kharper55/LiFi-Serial/Photos and Captures/Test Fixture/Front.jpg

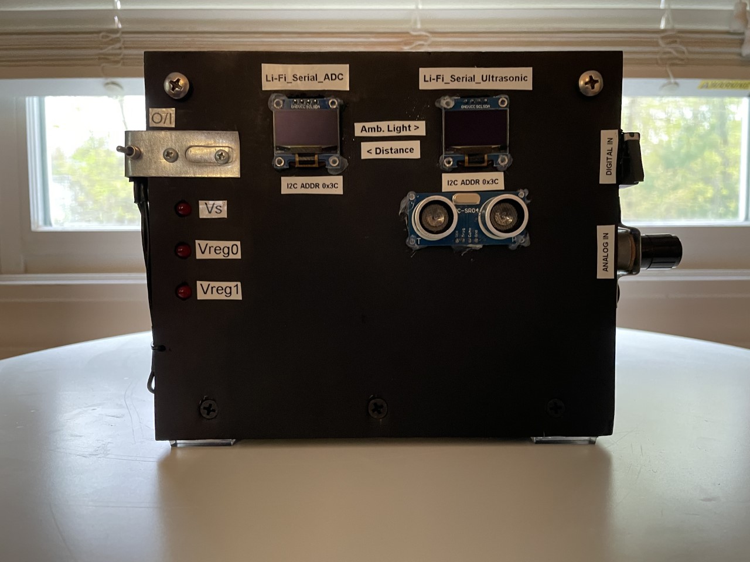
Photos and Captures/Test Fixture/Front.jpg
