kharper55/LiFi-Serial/Photos and Captures/Test Fixture/rear.jpg

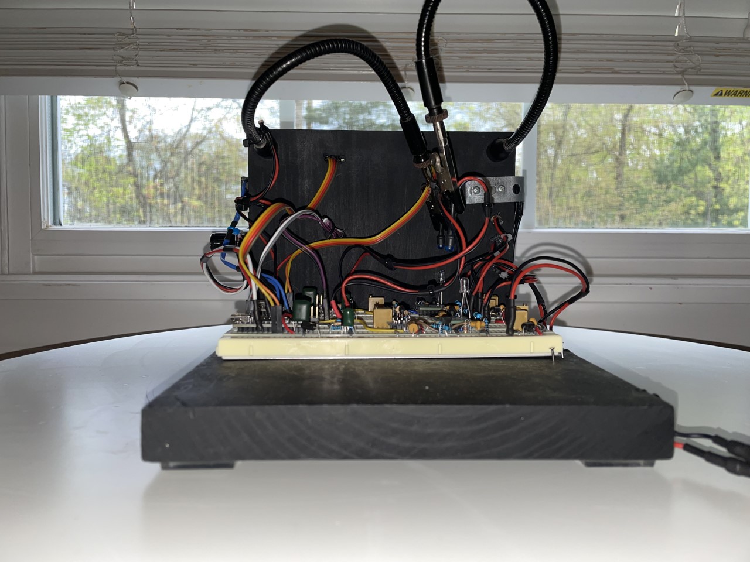
Photos and Captures/Test Fixture/rear.jpg
