kharper55/LiFi-Serial/Flowcharts/LiFi Serial_ ADC - Algorithm flowchart example (2).png

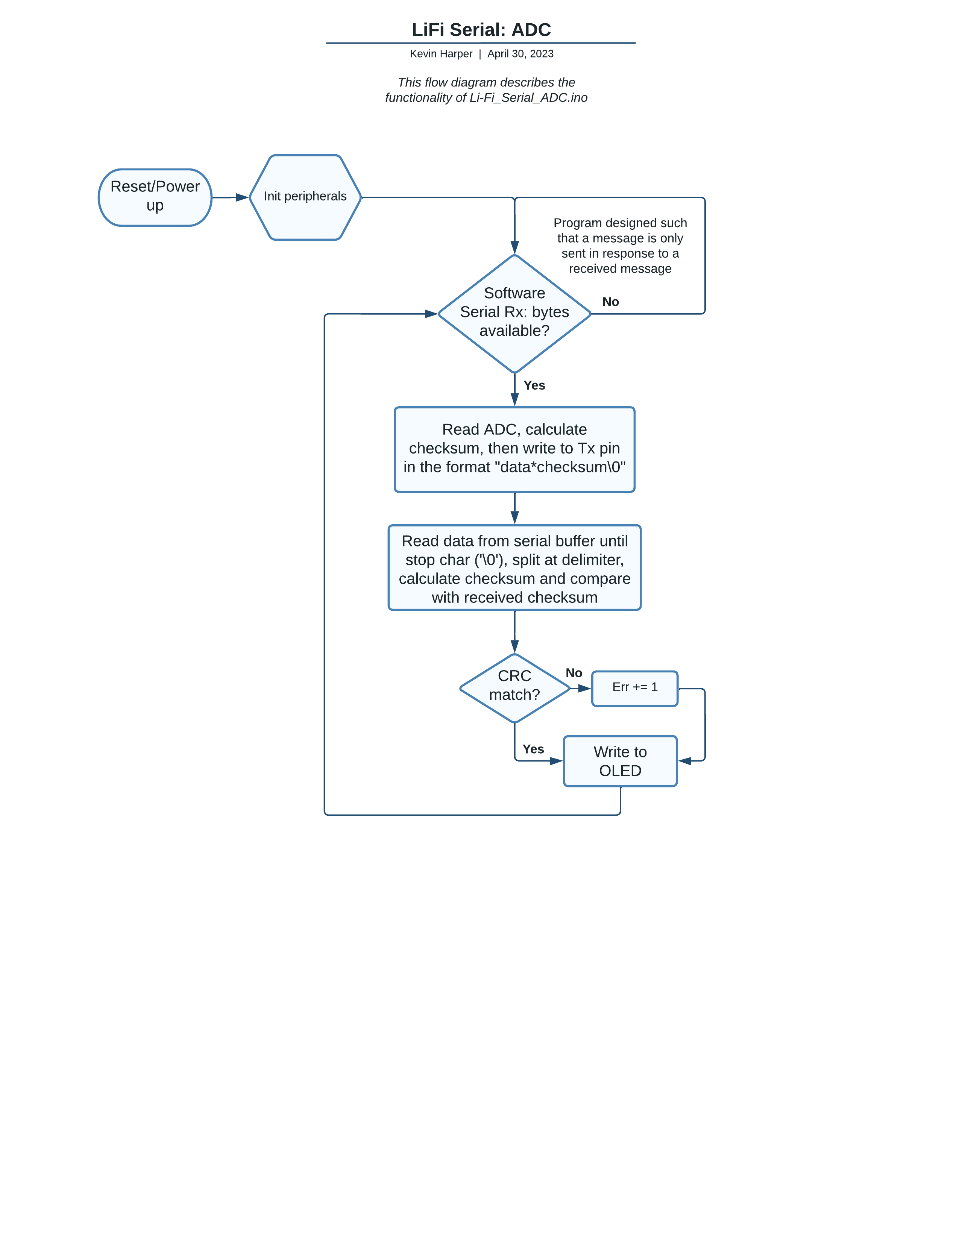
Flowcharts/LiFi Serial_ ADC - Algorithm flowchart example (2).png
