kharper55/LiFi-Serial/Photos and Captures/Scope Captures/bmps/ADCchecksum.bmp

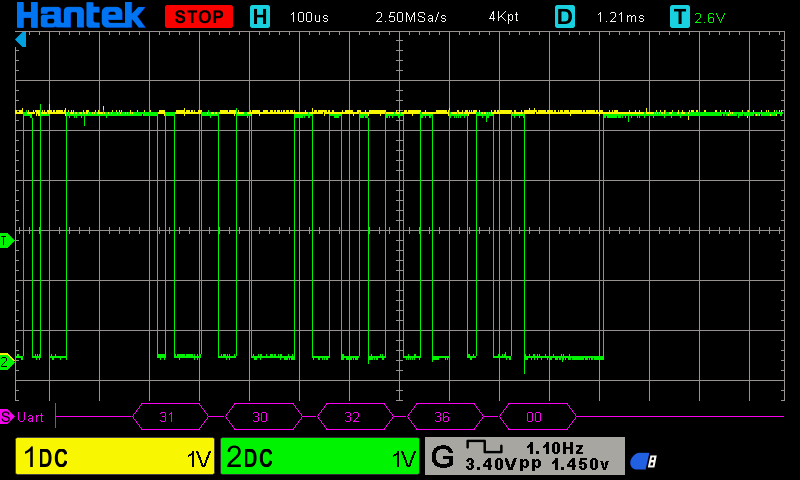
Photos and Captures/Scope Captures/bmps/ADCchecksum.bmp
