kharper55/LiFi-Serial/Photos and Captures/Scope Captures/bmps/ADCmsg.bmp

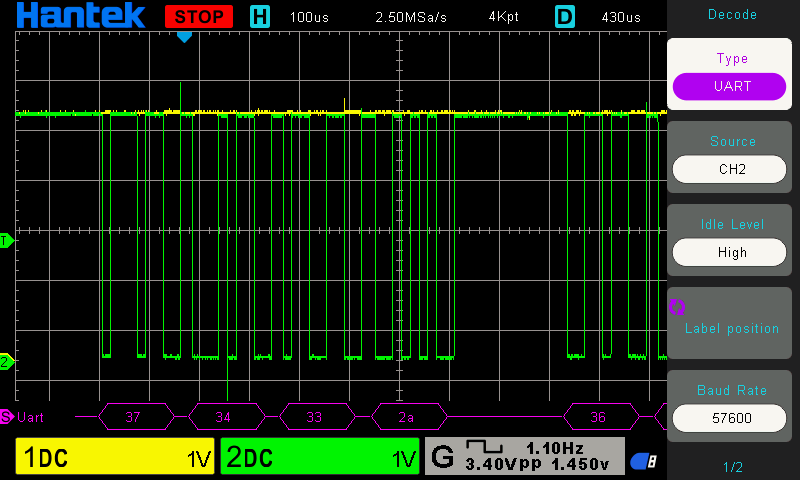
Photos and Captures/Scope Captures/bmps/ADCmsg.bmp
