kharper55/LiFi-Serial/Photos and Captures/Scope Captures/bmps/HalfDuplexProof.bmp

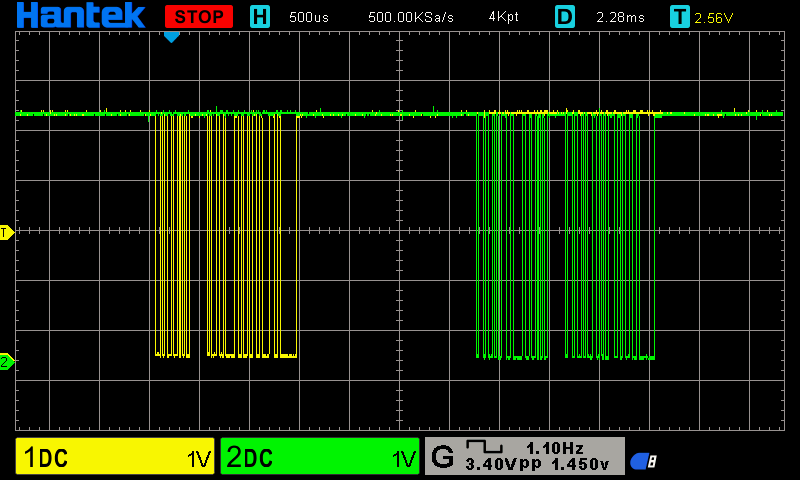
Photos and Captures/Scope Captures/bmps/HalfDuplexProof.bmp
