kharper55/LiFi-Serial/Photos and Captures/Scope Captures/bmps/HCSR04msg.bmp

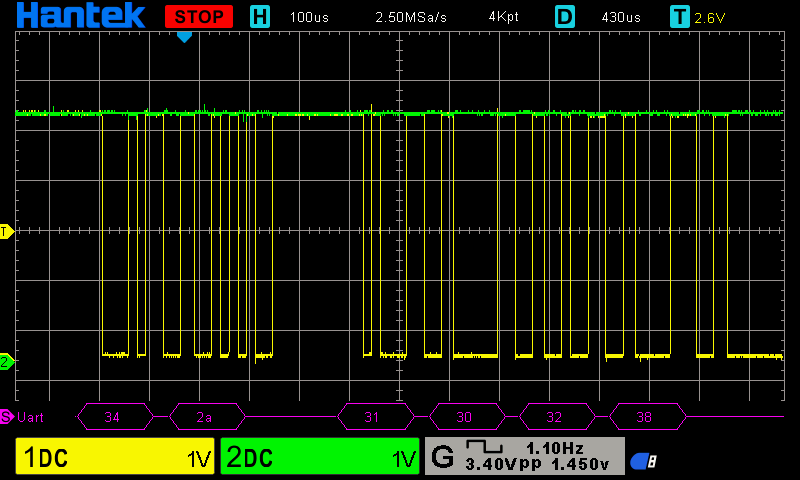
Photos and Captures/Scope Captures/bmps/HCSR04msg.bmp
