kharper55/LiFi-Serial/Photos and Captures/Scope Captures/bmps/HFpwm-OA&Comparator.bmp

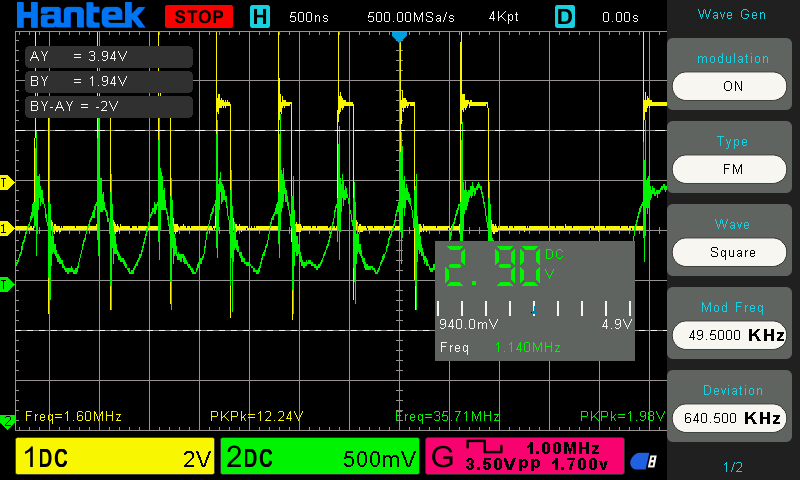
Photos and Captures/Scope Captures/bmps/HFpwm-OA&Comparator.bmp
