kharper55/LiFi-Serial/Photos and Captures/Scope Captures/bmps/opampVsComparatorOPs.bmp

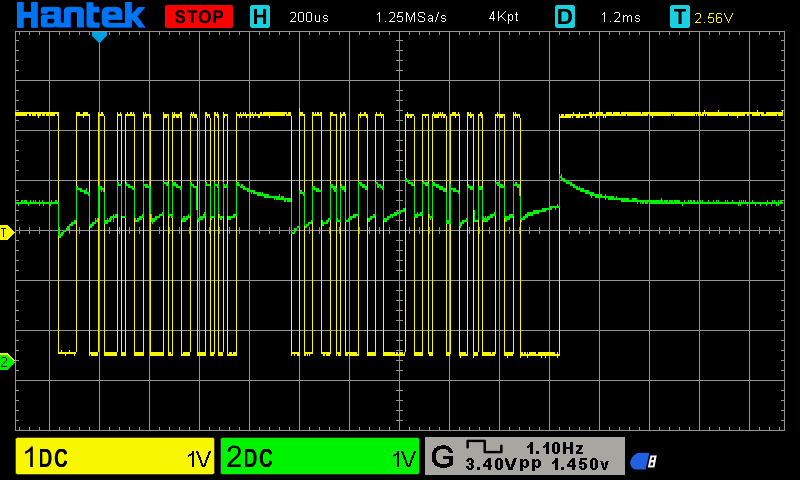
Photos and Captures/Scope Captures/bmps/opampVsComparatorOPs.bmp
