kharper55/LiFi-Serial/Photos and Captures/Scope Captures/bmps/timeDelay.bmp

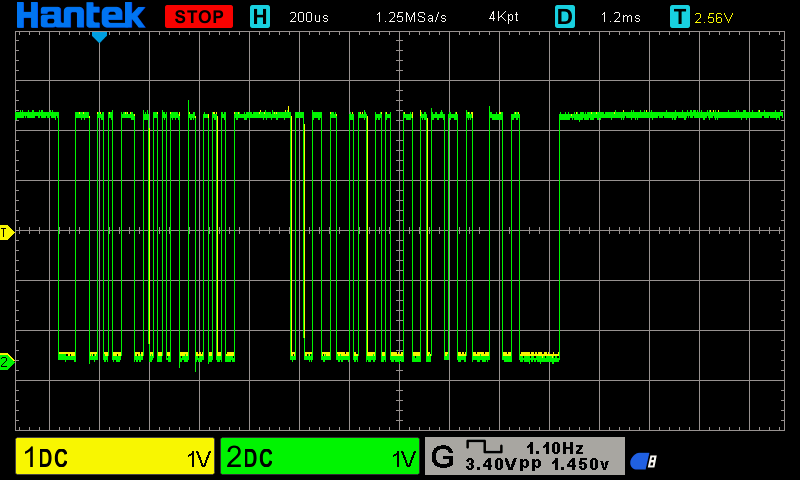
Photos and Captures/Scope Captures/bmps/timeDelay.bmp
