kharper55/LiFi-Serial/Photos and Captures/Scope Captures/bmps/TransmitterEx.bmp

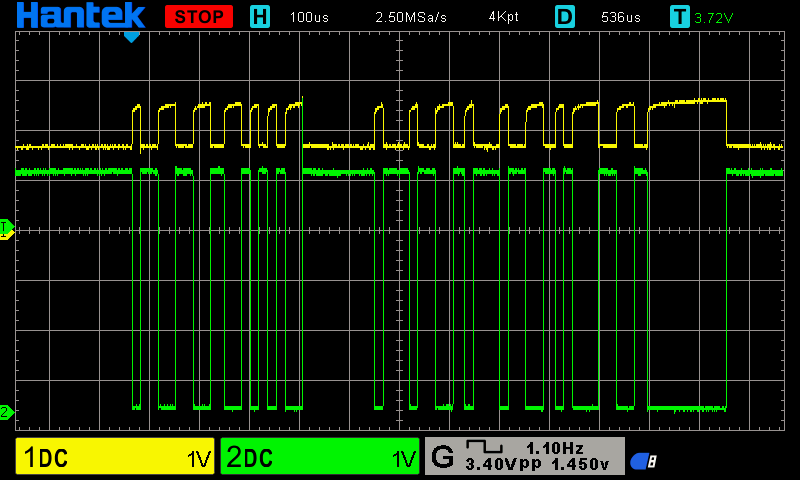
Photos and Captures/Scope Captures/bmps/TransmitterEx.bmp
