kharper55/LiFi-Serial/Photos and Captures/Scope Captures/bmps/VRailNoise.bmp

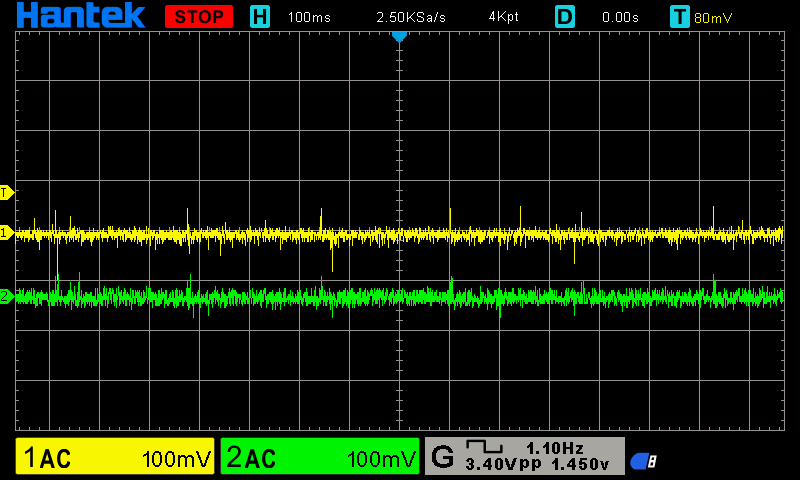
Photos and Captures/Scope Captures/bmps/VRailNoise.bmp
