kharper55/LiFi-Serial/Photos and Captures/Scope Captures/bmps/ZoomedTimeDelay.bmp

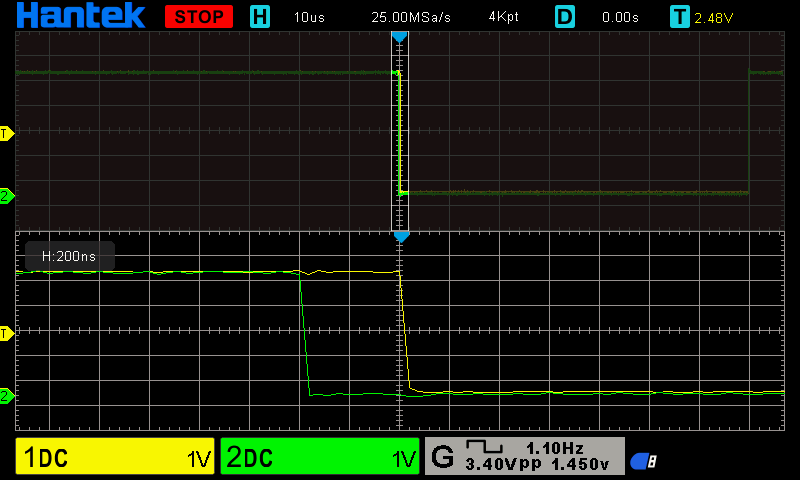
Photos and Captures/Scope Captures/bmps/ZoomedTimeDelay.bmp
