kharper55/LiFi-Serial/References/ASCII-Table-wide.svg.png

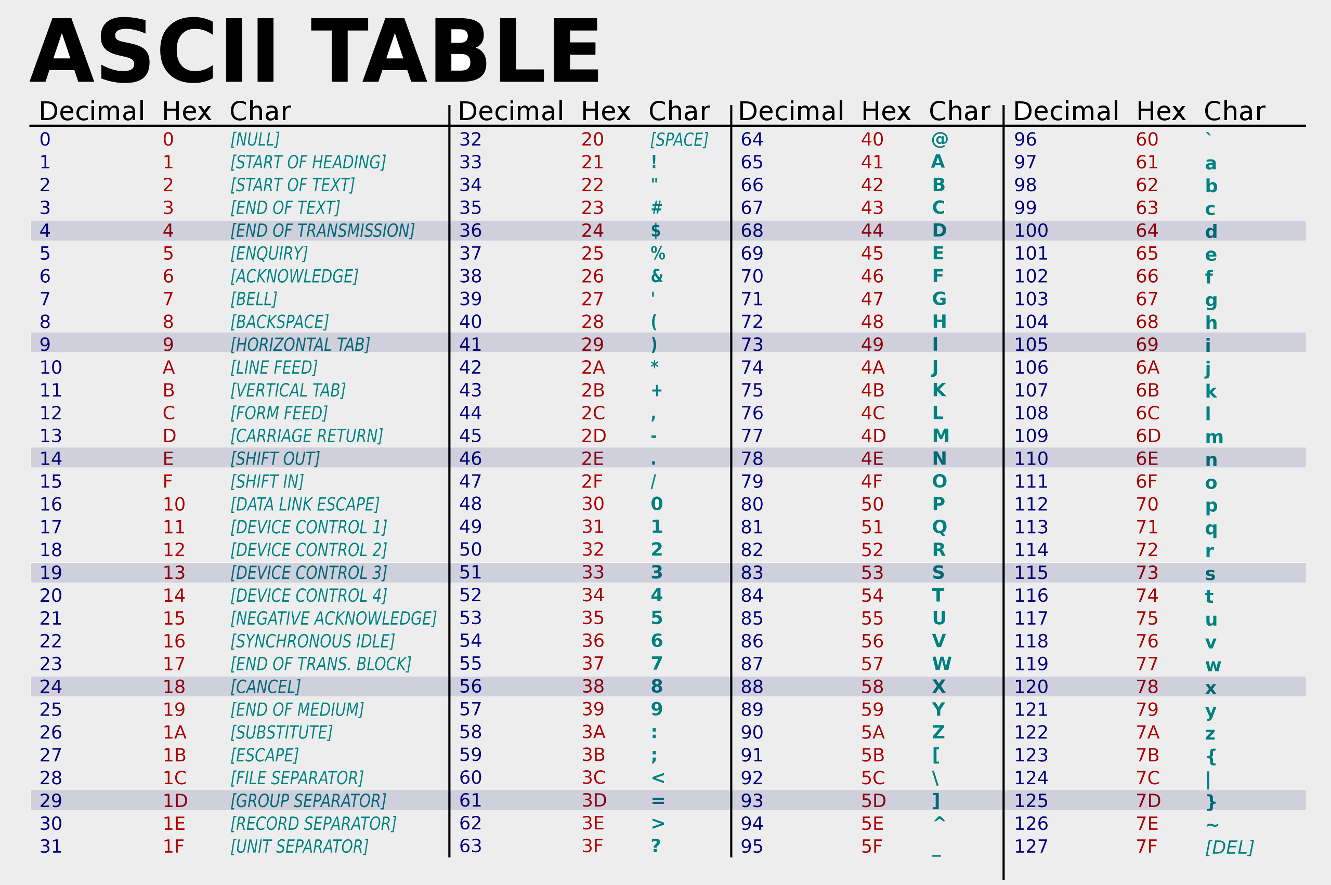
References/ASCII-Table-wide.svg.png
