kharper55/LiFi-Serial/Schematics/LiFiREVA.png

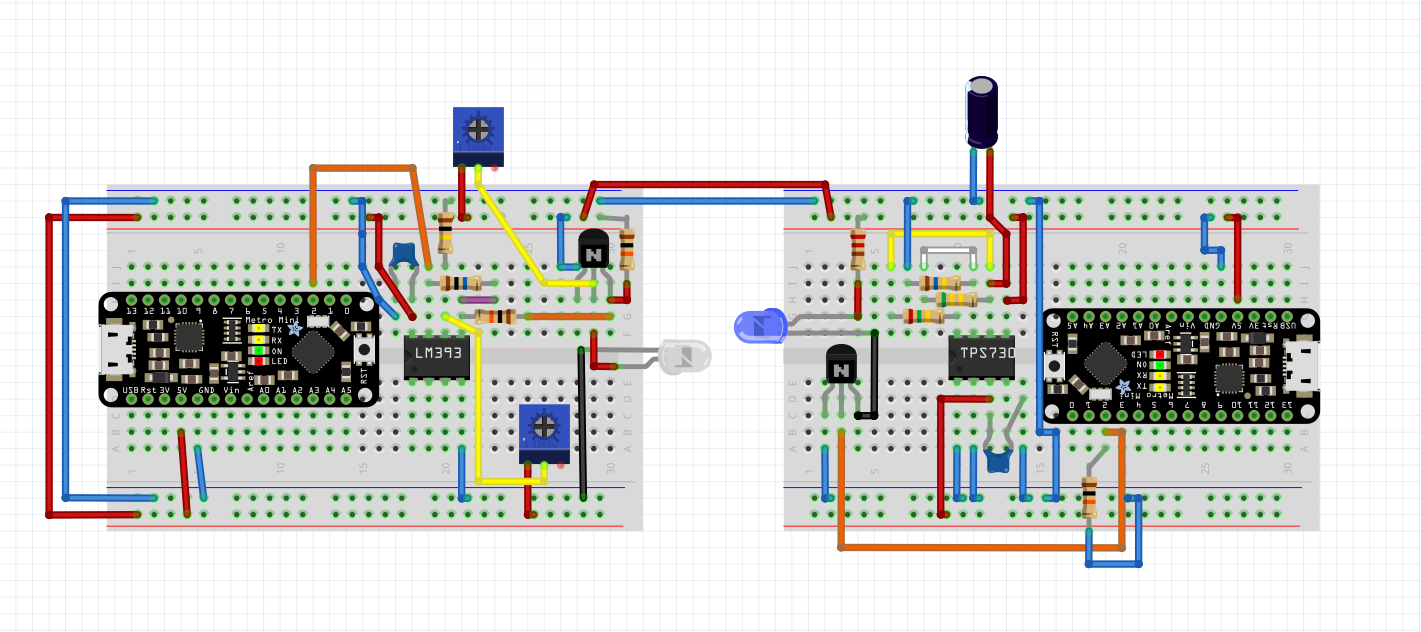
Schematics/LiFiREVA.png
