kharper55/LiFi-Serial/Schematics/powersupply.png

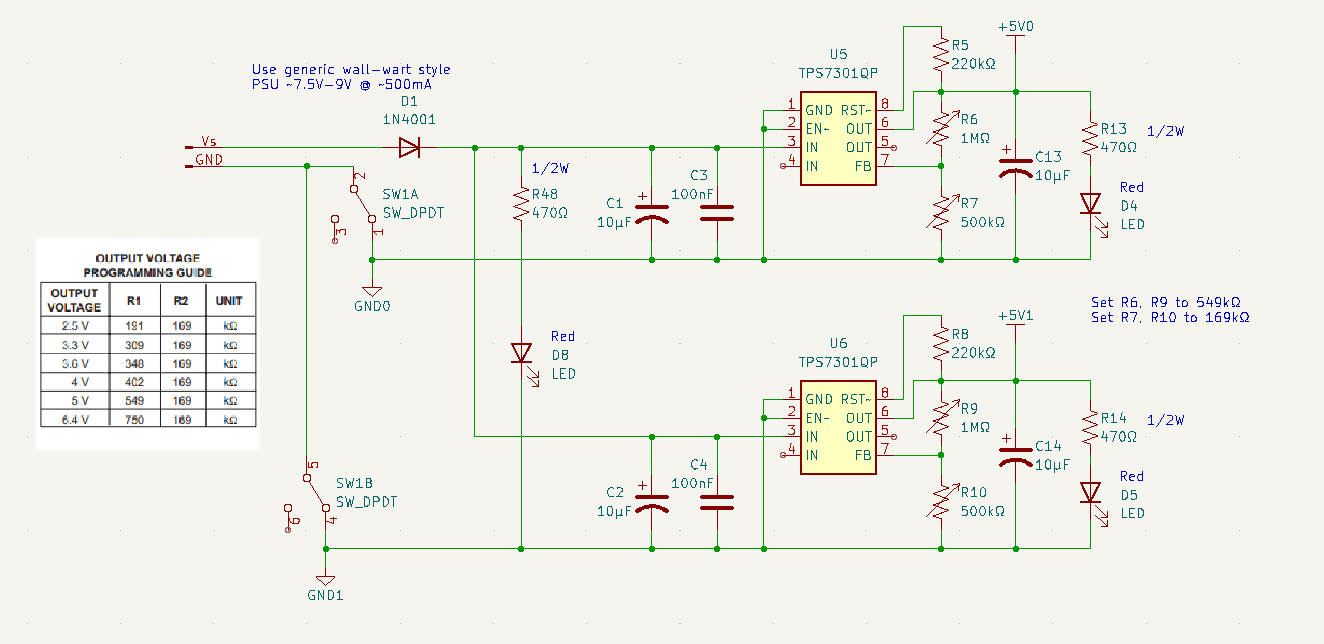
Schematics/powersupply.png
