kharper55/LiFi-Serial/Schematics/receiver.png

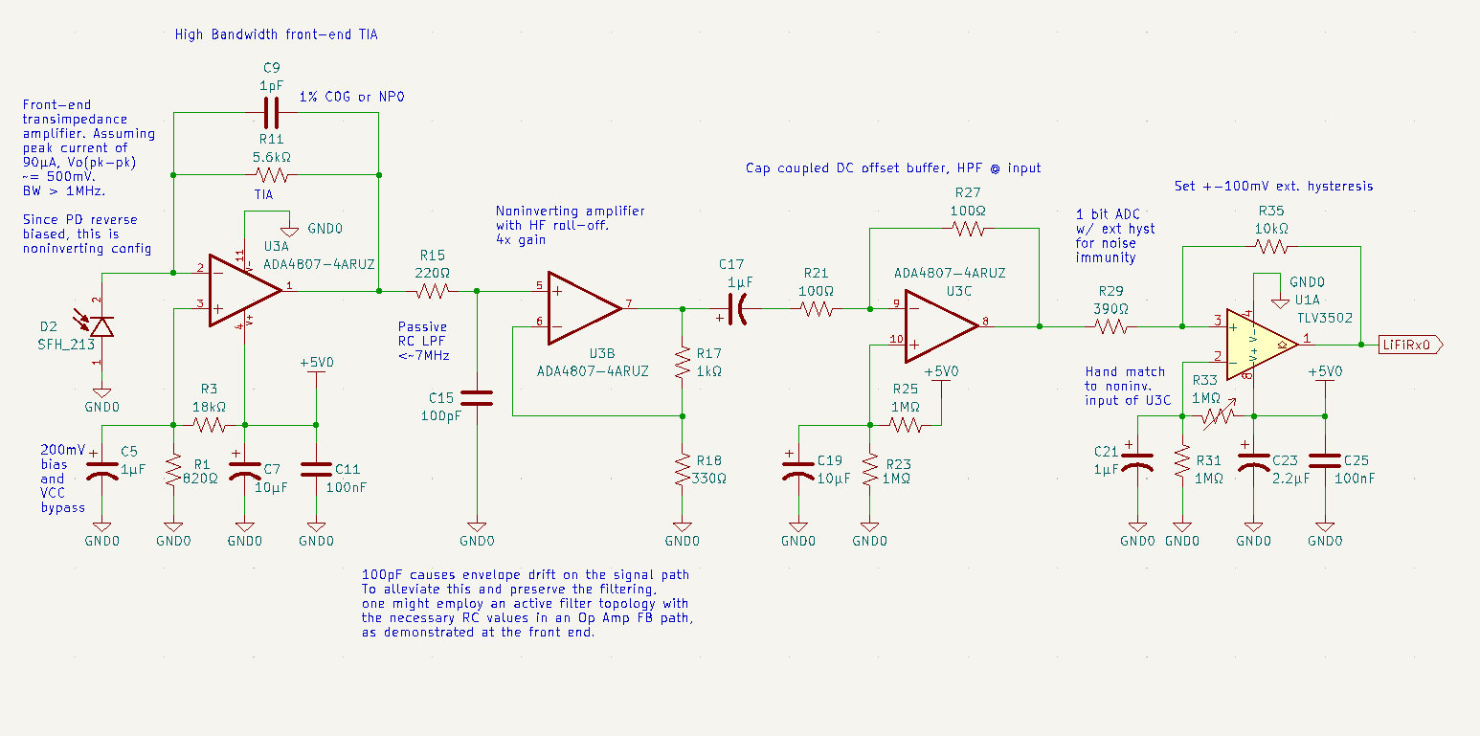
Schematics/receiver.png
