kharper55/LiFi-Serial/Schematics/transmitter.png

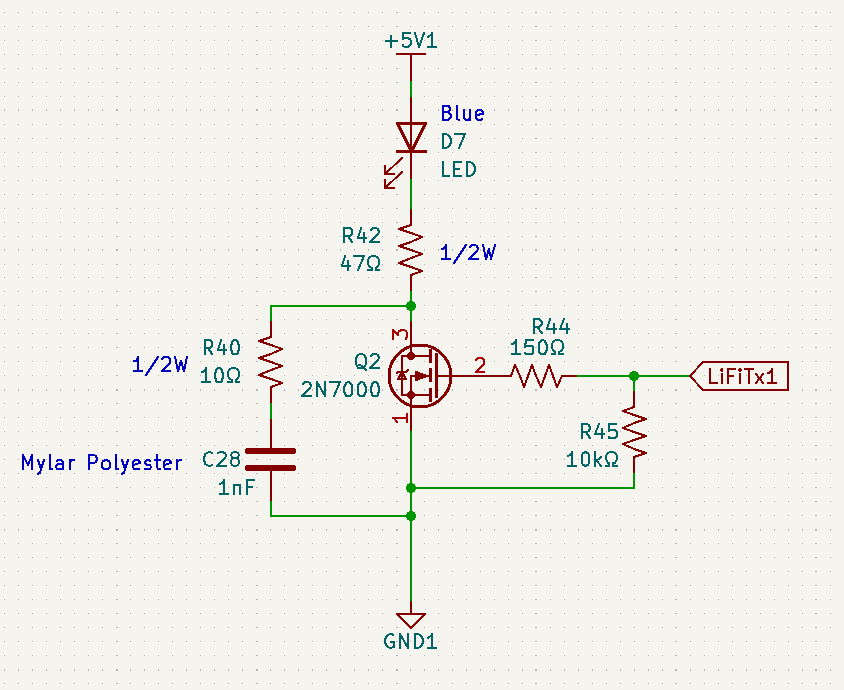
Schematics/transmitter.png
