kharper55/LiFi-Serial/Spr 2023 Li-Fi - BOM.xlsx

Item | Qty | Reference Designators | Description | Value | Manufacturer/Source | MPN | Datasheet | Unit Price
1 | 8 | C1, C2, C7, C8, C13, C14, C19, C20 | 10 µF Molded Tantalum Capacitors 10 V Axial | 10µF | Vishay Sprague | 173D106X9010VWE3 | https://www.vishay.com/docs/40019/173d.pdf | $1.55
2 | 8 | C3, C4, C11, C12, C25, C26, C29, C31 | CAP CER 0.1UF 50V Z5U RADIAL | 100nF | Kemet | C315C104M5U5TA7303 | https://connect.kemet.com:7667/gateway/IntelliData-ComponentDocumentation/1.0/download/specsheet/C315C104M5U5TA7303 | $0.32
3 | 8 | C5, C6, C17, C18, C21, C22, C30, C32 | 1 µF Molded Tantalum Capacitors 35 V Axial 8Ohm | 1µF | Kemet | T322B105K035AT | https://connect.kemet.com:7667/gateway/IntelliData-ComponentDocumentation/1.0/download/datasheet/T322B105K035AT | $4.52
4 | 2 | C9, C10 | Multilayer Ceramic Capacitors MLCC - Leaded, 1% C0G NP0 | 1pF | Murata | RCE5C1H1R0C0K1H03B | https://www.mouser.com/datasheet/2/281/RCE_C0G_50V_100V_E-1671015.pdf | $0.48 | Components grabbed are not necessarily representative of what's on the board, but rather the first match for spec and component package and availability on Digikey or Mouser. BOM cost can be greatly reduced by replacing some of the tantalum capacitors with electrolytics along with swapping for lower spec'd IC's (performance will decrease)
5 | 2 | C15, C16 | 100 pF ±5% 200V Ceramic Capacitor C0G, NP0 Radial | 100pF | Kemet | C317C101J2G5TA | https://content.kemet.com/datasheets/KEM_C1049_GOLDMAX_C0G.pdf | $0.43
6 | 2 | C23, C24 | 2.2 µF Molded Tantalum Capacitors 25 V Axial | 2.2µF | Vishay Sprague | 173D225X9025VWE3 | https://www.vishay.com/docs/40019/173d.pdf | $1.55
7 | 2 | C27, C28 | 1000 pF Film Capacitor 100V Polyester Radial | 1nF | Nichicon | QYX2A102JTP | https://www.nichicon.co.jp/english/series_items/catalog_pdf/e-qyx.pdf | $0.44
8 | 1 | D1 | Rectifiers Diode, DO-41, 50V, 1A | N/A | Diotec | 1N4001 | https://www.mouser.com/datasheet/2/849/1n4001-2577232.pdf | $0.40
9 | 2 | D2, D3 | Silicon PIN Photodiode | N/A | ams Osram | SFH213 | https://docs.rs-online.com/f594/0900766b814f568d.pdf | $0.87
10 | 3 | D4, D5, D8 | Red 630nm LED Indication - Discrete 2V Radial | N/A | Rohm | SLR-56VC3F | https://fscdn.rohm.com/en/products/databook/datasheet/opto/led/lamp_mono/slr-56-e.pdf | $0.53
11 | 2 | D6, D7 | Blue 470nm LED Indication - Discrete 3.2V Radial | N/A | Wurth Elektronik | 151051BS04000 | https://www.we-online.com/components/products/datasheet/151051BS04000.pdf | $0.26
12 | 2 | J2, J3 | HiLetgo 0.96" SSD1306 I2C IIC SPI Serial 128X64 OLED LCD Display 4 Pin Font Color White | N/A | Amazon/HILETGO | 3-01-1234-IIC-W | https://www.vishay.com/docs/37902/oled128o064dbpp3n00000.pdf | $7.29
13 | 2 | Q1, Q2 | N-Channel Enhancement FET, Logic Level | N/A | Fairchild | 2N7000 | https://rocelec.widen.net/view/pdf/orqxwkxkq1/ONSM-S-A0003544006-1.pdf?t.download=true&u=5oefqw | $0.51
14 | 2 | R1, R2 | 820 Ohms ±1% 0.25W, 1/4W Through Hole Resistor Axial Flame Retardant Coating, Safety Metal Film | 820Ω | Stackpole Electronics Inc | RNMF14FTC820R | https://www.seielect.com/Catalog/SEI-RNF_RNMF.pdf | $0.10
15 | 2 | R3, R4 | 18 kOhms ±1% 0.25W, 1/4W Through Hole Resistor Axial Flame Retardant Coating, Safety Metal Film | 18kΩ | Stackpole Electronics Inc | RNMF14FTC18K0 | https://www.seielect.com/Catalog/SEI-RNF_RNMF.pdf | $0.10
16 | 2 | R5, R8 | 220 kOhms ±1% 0.25W, 1/4W Through Hole Resistor Axial Flame Retardant Coating, Safety Metal Film | 220kΩ | Stackpole Electronics Inc | RNMF14FTC220K | https://www.seielect.com/Catalog/SEI-RNF_RNMF.pdf | $0.10
17 | 2 | R7, R10 | 500 kOhms 0.5W, 1/2W PC Pins Through Hole Trimmer Potentiometer Cermet 25.0 Turn Top Adjustment | 500kΩ, Linear | Bourns Inc. | 3296W-1-504LF | https://www.bourns.com/docs/product-datasheets/3296.pdf | $2.43
18 | 2 | R11, R12 | 5.6 kOhms ±1% 0.25W, 1/4W Through Hole Resistor Axial Flame Retardant Coating, Safety Metal Film | 5.6kΩ | Stackpole Electronics Inc | RNMF14FTC5K60 | https://www.seielect.com/Catalog/SEI-RNF_RNMF.pdf | $0.10
19 | 2 | R13, R14, R48 | 470 Ohms ±1% 0.5W, 1/2W Through Hole Resistor Axial Metal Film | 470Ω | Yageo | MFR50SFRF52-470R | https://www.yageo.com/upload/media/product/productsearch/datasheet/lr/YAGEO%20MFR_datasheet_2021v1.pdf | $0.11
20 | 2 | R15, R16 | 220 Ohms ±1% 0.25W, 1/4W Through Hole Resistor Axial Flame Retardant Coating, Safety Metal Film | 220Ω | Stackpole Electronics Inc | RNMF14FTC220R | https://www.seielect.com/Catalog/SEI-RNF_RNMF.pdf | $0.10
21 | 2 | R17, R19 | 1 kOhms ±1% 0.25W, 1/4W Through Hole Resistor Axial Flame Retardant Coating, Safety Metal Film | 1kΩ | Stackpole Electronics Inc | RNMF14FTC1K00 | https://www.seielect.com/Catalog/SEI-RNF_RNMF.pdf | $0.10
22 | 2 | R18, R20 | 330 Ohms ±1% 0.25W, 1/4W Through Hole Resistor Axial Flame Retardant Coating, Safety Metal Film | 330Ω | Stackpole Electronics Inc | RNMF14FTC330R | https://www.seielect.com/Catalog/SEI-RNF_RNMF.pdf | $0.10
23 | 4 | R21, R22, R27, R28 | 100 Ohms ±1% 0.25W, 1/4W Through Hole Resistor Axial Flame Retardant Coating, Safety Metal Film | 100Ω | Stackpole Electronics Inc | RNF14FTD100R | https://www.seielect.com/Catalog/SEI-RNF_RNMF.pdf | $0.10
24 | 6 | R23, R24, R25, R26, R31, R32 | 1 MOhms ±1% 0.25W, 1/4W Through Hole Resistor Axial Flame Retardant Coating, Safety Metal Film | 1MΩ | Stackpole Electronics Inc | RNF14FTD1M00 | https://www.seielect.com/Catalog/SEI-RNF_RNMF.pdf | $0.10
25 | 2 | R29, R30 | 390 Ohms ±1% 0.25W, 1/4W Through Hole Resistor Axial Flame Retardant Coating, Safety Metal Film | 390Ω | Stackpole Electronics Inc | RNMF14FTC390R | https://www.seielect.com/Catalog/SEI-RNF_RNMF.pdf | $0.10
26 | 4 | R6, R9, R33, R34 | 1 MOhms 0.5W, 1/2W PC Pins Through Hole Trimmer Potentiometer Cermet 25.0 Turn Top Adjustment | 1MΩ, Linear | Bourns Inc. | 3296Y-1-105LF | https://www.bourns.com/docs/product-datasheets/3296.pdf | $2.43
27 | 6 | R35, R36, R41, R43, R45, R46 | 10 kOhms ±5% 0.25W, 1/4W Through Hole Resistor Axial Flame Retardant Coating, Safety Carbon Film | 10kΩ | Stackpole Electronics Inc | CF14JT10K0 | https://www.seielect.com/Catalog/SEI-CF_CFM.pdf | $0.10
28 | 2 | R37, R40 | 10 Ohms ±1% 0.5W, 1/2W Through Hole Resistor Axial Metal Film | 10Ω | Yageo | MFR50SFTE52-10R | https://www.yageo.com/upload/media/product/productsearch/datasheet/lr/YAGEO%20MFR_datasheet_2021v1.pdf | $0.11
29 | 2 | R38, R42 | 47 Ohms ±1% 0.5W, 1/2W Through Hole Resistor Axial Metal Film | 47Ω | Yageo | MFR50SFTE52-47R | https://www.yageo.com/upload/media/product/productsearch/datasheet/lr/YAGEO%20MFR_datasheet_2021v1.pdf | $0.11
30 | 2 | R39, R44 | 150 Ohms ±1% 0.25W, 1/4W Through Hole Resistor Axial Flame Retardant Coating, Safety Metal Film | 150Ω | Stackpole Electronics Inc | RNF14FTD150R | https://www.seielect.com/Catalog/SEI-RNF_RNMF.pdf | $0.10
31 | 1 | R47 | Light Dependent Resistor (LDR) CdS Photocell | 6-14k | Advanced Photonix | NSL-5112 | https://www.advancedphotonix.com/wp-content/uploads/2015/07/DS-NSL-5112.pdf | $1.31
32 | 1 | RV1 | PDB18 Series - 17 mm Rotary Potentiometer | 10kΩ, Linear | Bourns Inc. | PDB181-K420K-103B | https://www.bourns.com/docs/Product-Datasheets/PDB18.pdf | $1.47
33 | 1 | SW1 | Toggle Switch DPDT Panel Mount, Right Angle | DPDT | E-Switch | 100DP1T1B1M6QE | https://sten-eswitch-13110800-production.s3.amazonaws.com/system/asset/product_line/data_sheet/129/100.pdf | $4.45
34 | 1 | SW2 | Switch SPDT Chassis Mount, Levered Limit Switch | N.O. | TE Connectivity ALCOSWITCH | SAJ25YXHL0147SDTSEQ | https://www.te.com/commerce/DocumentDelivery/DDEController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 | $1.51
35 | 2 | TB0, TB1 | Nano V3.0, Nano Board ATmega328P 5V 16M Micro-Controller Board Compatible with Arduino IDE (Nano x 3 with USB Cable) | N/A | Amazon/LAVFIN | 8541582500 | https://docs.arduino.cc/static/22b08d6798567faa67448967799d321c/A000005-datasheet.pdf | $7.33
36 | 2 | U1, U2 | 4.5-ns Rail-to-Rail High-Speed Comparator | N/A | Texas Instruments | TLV3502AIDR | https://www.ti.com/lit/ds/sbos507a/sbos507a.pdf?ts=1682147923610 | $5.01
37 | 2 | U3, U4 | High Speed Operational Amplifiers 180MHz, 3.1 nV/vHz, 1mA, RRIO Quad Opamp | N/A | Analog Devices | ADA4807-4ARUZ-R7 | https://www.mouser.com/datasheet/2/609/ADA4807_1_4807_2_4807_4-3119636.pdf | $7.99
38 | 2 | U5, U6 | 500-mA, 10V, low-dropout voltage regulator with power good & enable | N/A | Texas Instruments | TPS7301QP | https://www.ti.com/lit/ds/symlink/tps73.pdf?ts=1682220527382 | $3.38
39 | 1 | U9 | Ultrasonic Sensor 40kHz | N/A | Adafruit Industries | HC-SR04 | https://cdn.sparkfun.com/datasheets/Sensors/Proximity/HCSR04.pdf | $3.95
40 | 1 | N/A | DC 9V 0.5A 500mA Power Supply Adapter, Plug 5.5mm x 2.1mm, Center Positive,UL Listed | N/A | Amazon/Security-01 | MLF-A250900500CU | https://www.amazon.com/Security-01-Supply-Adapter-Center-Positive/dp/B09JVZ71TH?hvadid=563725902662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 | $9.99
41 | 1 | N/A | SMT Breakout PCB for SOIC-8, MSOP-8 or TSSOP-8-6 Pack | N/A | Amazon/Adafruit | 100634 | https://www.amazon.com/Adafruit-Breakout-SOIC-8-MSOP-8-TSSOP-8-6/dp/B00OKCOKVE?s=industrial | $6.96
42 | 1 | N/A | Proto-Advantage PA0033 TSSOP-14 to DIP-14 SMT Adapter (0.65 mm Pitch) | N/A | Amazon/ChipQuik | PA0033-3X | https://www.amazon.com/dp/B097Q682QY?psc=1&ref=ppx_yo2ov_dt_b_product_details | $11.07
43 | 1 | N/A | 63-37 Tin Lead Rosin Core Solder Wire for Electrical Soldering (0.6mm 50g) | N/A | Amazon/Maiyum | ‎JF650 | https://www.amazon.com/MAIYUM-63-37-Solder-Electrical-Soldering/dp/B075WBDYZZ | $8.99
44 | 1 | N/A | 10cm+20cm 240pcs Breadboard Jumper Dupont Wires Cable Kit Male to Female, Male to Male, Female to Female Compatible with Arduino Projects and Raspberry Pi | N/A | Amazon/EDGELEC | ED-DP_L20_Mix_120pcs | https://www.amazon.com/EDGELEC-Breadboard-Optional-Assorted-Multicolored/dp/B07GD2BWPY?s=industrial | $6.99
45 | 1 | N/A | 14 Vaules 840 pcs 2-125mm Solderless Flexible Breadboard Connecting Line Cables Breadboard Jumper Wires kit | N/A | Amazon/BOJACK | BJ-14V-840P | https://www.amazon.com/BOJACK-Solderless-Flexible-Breadboard-Connecting/dp/B08YRGVYPV | $13.99
46 | 1 | N/A | 24 Gauge Wire - 6 Colors Tinned Copper Wires with Silicone Rubber Insulation (Black, Red, Yellow, Green, Blue, White) 30ft / 9m Each - 24 AWG (OD: 1.6 mm) Stranded Hook Up Wires from Plusivo | N/A | Amazon/Plusivo | 24GA | https://www.amazon.com/24-Gauge-Wire-Silicone-Insulation/dp/B087TJNJZS | $16.99
47 | 1 | N/A | 22-18 AWG 0.156 in. Tab Butt Splice 5 Male 5 Female, Red (10-Pack) | N/A | Home Depot/Gardner Bender | 20-161P | https://www.homedepot.com/p/Gardner-Bender-22-18-AWG-0-156-in-Tab-Butt-Splice-5-Male-5-Female-Red-10-Pack-20-161P/205846720 | $2.95
48 | 2 | N/A | Jameco Valuepro 830-Point Solderless Breadboard, 6.5" x 2.125", 0.1" spread | N/A | Amazon/Jameco | WBU-202-R | https://www.jameco.com/Jameco/Products/ProdDS/20723.pdf | $12.34
49 | 1 | N/A | 3/4 in. x 30 ft. Commercial Carded Electrical Tape, Black | N/A | Home Depot/Commercial Electric | EC-800 | https://www.homedepot.com/p/Commercial-Electric-3-4-in-x-30-ft-Commercial-Carded-Electrical-Tape-Black-EC-800/309810154 | $1.58
50 | 1 | N/A | Black Heat Shrink Tubing Assorted Kit 3in. 2:1 Shrink Ratio | N/A | Home Depot/Eclipse Tools | 902-355 | https://www.homedepot.com/p/Eclipse-Tools-Heat-Shrink-Tubing-Black-902-355/206369470 | $10.39
51 | 1 | N/A | Pin Header Strip for Arduino GPIO 40 pin x 10pcs Male Headers Pins Straight Single Row Gold Plated Pitch 2.54mm 0.1 inch Breakaway for PCB Connector Machine Breadboard Electronic Circuit Board | N/A | Amazon/Chanzon | LJQ-ZP-40P-DPZ-2.54-10 | https://www.amazon.com/Straight-Breakaway-Connector-Breadboard-Electronic/dp/B09MYBRW3F?s=industrial | $7.99
52 | 1 | N/A | #19 x 1/2 in. Zinc Wire Nails | N/A | Home Depot/Everbilt | 802664 | https://www.homedepot.com/p/19-x-1-2-in-Zinc-Wire-Nails-2-oz-per-pack-802664/204281736 | $2.56
53 | 1 | N/A | 4 in. UV Cable Tie, Black (40-Pack) | N/A | Home Depot/Commercial Electric | GT-100MB(40) | https://www.homedepot.com/p/Commercial-Electric-4-in-UV-Cable-Tie-Black-40-Pack-GT-100MB-40/203531951 | $5.98
54 | 1 | N/A | Rust-Oleum Painter's Touch 2X 12 oz. Flat Black General Purpose Spray Paint | N/A | Home Depot/Rustoleum | 334020 | https://images.thdstatic.com/catalog/pdfImages/34/3469adc0-93a5-4b51-adc8-9050374b411b.pdf | $6.48
55 | 1 | N/A | 1/2 in. x 1 in. Clear Soft Rubber Like Plastic Self-Adhesive Rectangular Bumpers (8-Pack) | N/A | Home Depot/Everbilt | 49963 | https://www.homedepot.com/p/Everbilt-1-2-in-x-1-in-Clear-Soft-Rubber-Like-Plastic-Self-Adhesive-Rectangular-Bumpers-8-Pack-49963/300194069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 | $4.60
56 | 1 | N/A | 2 Pack Set Flexible Gooseneck Metal Arms with Alligator Clips for Helping Hands Third Hand Tool Automobile Electronics Soldering Jewelry Painting Art Crafts Hobby | N/A | Amazon/FstopLabs | ‎ARM_ALG | https://www.amazon.com/Gooseneck-Alligator-Automobile-Electronics-Soldering/dp/B07XNXH3JT?s=industrial | $11.99
57 | 1 | N/A | 4 in. Mini Hot Glue Sticks (30-Count) | N/A | Home Depot/Gorilla | 3023003 | https://www.homedepot.com/p/Gorilla-4-in-Mini-Hot-Glue-Sticks-30-Count-3023003/311537985 | $4.43
58 | 1 | N/A | 3/4 in. x 10 ft. Galvanized Interlocking Metal Hanger Strap | N/A | Home Depot/Oatey | 33989 | https://www.homedepot.com/p/Oatey-3-4-in-x-10-ft-Galvanized-Interlocking-Metal-Hanger-Strap-33989/100168794 | $6.46
59 | 1 | N/A | #8 x 1/2 in. Philips Truss-Head Standard Thread Wood Screw Zinc (100-Pack) | N/A | Home Depot/Rok | ROKS8X12TPSZ-100 | https://www.homedepot.com/p/Rok-8-x-1-2-in-Philips-Truss-Head-Standard-Thread-Wood-Screw-Zinc-100-Pack-ROKS8X12TPSZ-100/303035163 | $8.99
60 | 1 | N/A | Grip Rite #6 x 2 in. Philips Bugle-Head Coarse Thread Sharp Point Drywall Screws (1 lb./Pack) | N/A | Home Depot/Grip-Rite | 2CDWS1 | https://www.homedepot.com/p/Grip-Rite-Grip-Rite-6-x-2-in-Philips-Bugle-Head-Coarse-Thread-Sharp-Point-Drywall-Screws-1-lb-Pack-2CDWS1/100128601 | $8.38
61 | 2 | N/A | 3/4 in. x 11-1/4 in. x $7.61/foot Poplar Wood | N/A | Home Depot | 106440 | https://www.homedepot.com/p/3-4-in-x-11-1-4-in-x-Random-Length-Poplar-Board-106440/206089817 | $7.61
62 | 1 | N/A | Arduino Source Code 0 | Li-Fi_Serial_Distance.ino | N/A | N/A | N/A | N/A
63 | 1 | N/A | Arduino Source Code 1 | Li-Fi_Serial_ADC.ino | N/A | N/A | N/A | N/A
TOTAL |  |  |  |  |  |  |  | $353.18
