kharper55/LiFi-Serial/Photos and Captures/Scope Captures/bmps/comparatorTest-1M.bmp

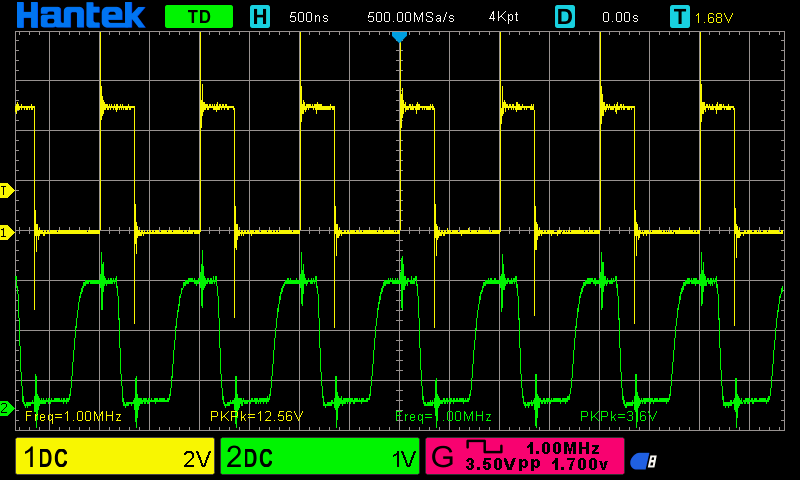
Photos and Captures/Scope Captures/bmps/comparatorTest-1M.bmp
