kharper55/LiFi-Serial/Photos and Captures/Test Fixture/iso.jpg

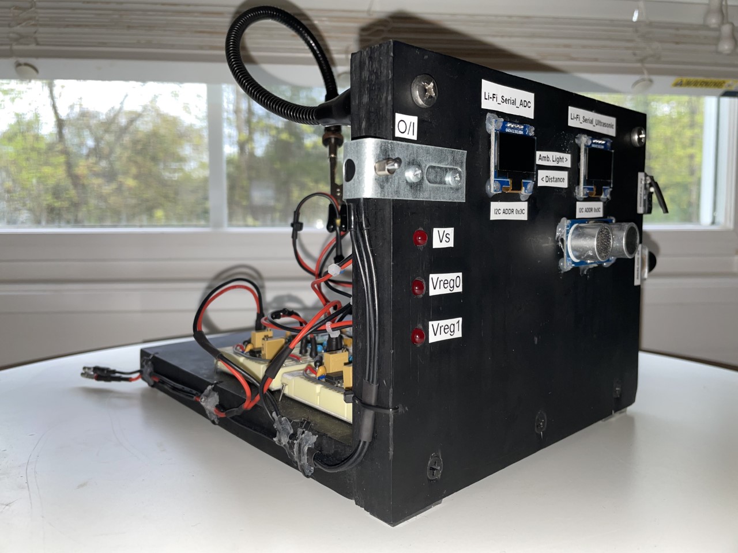
Photos and Captures/Test Fixture/iso.jpg
