kharper55/LiFi-Serial/Photos and Captures/Test Fixture/left.jpg

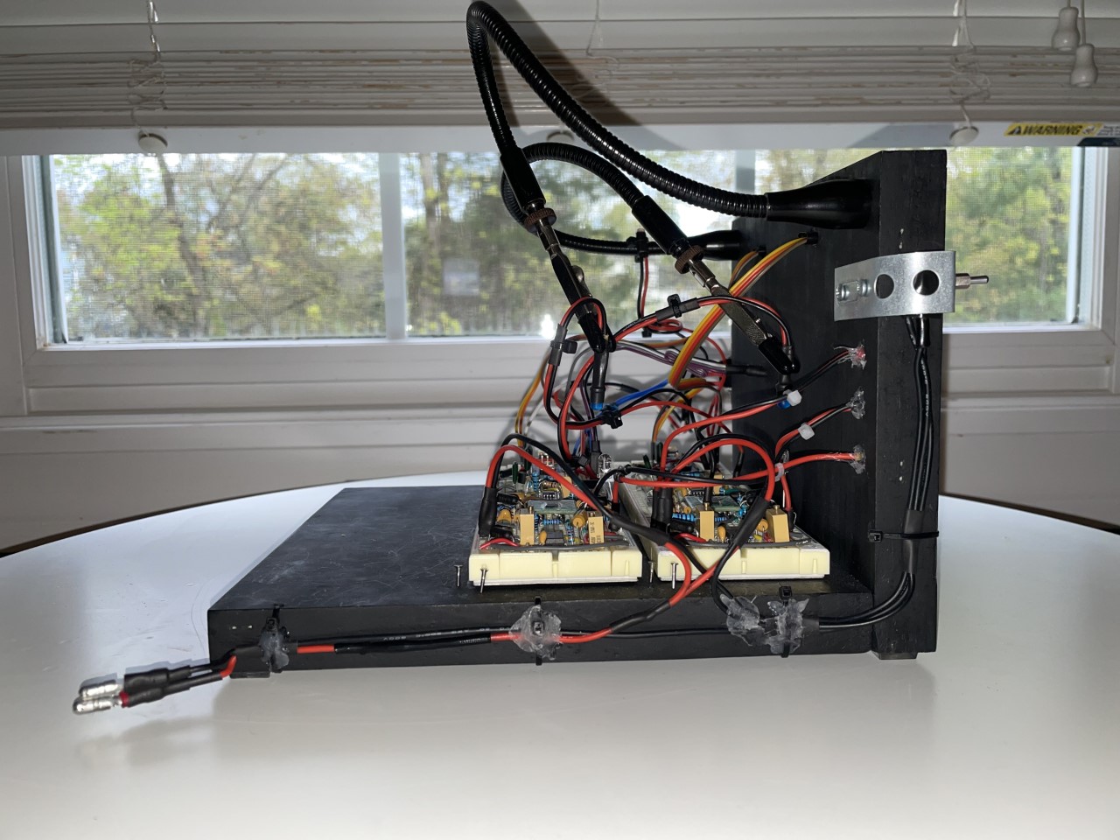
Photos and Captures/Test Fixture/left.jpg
