kharper55/LiFi-Serial/Photos and Captures/Test Fixture/right.jpg

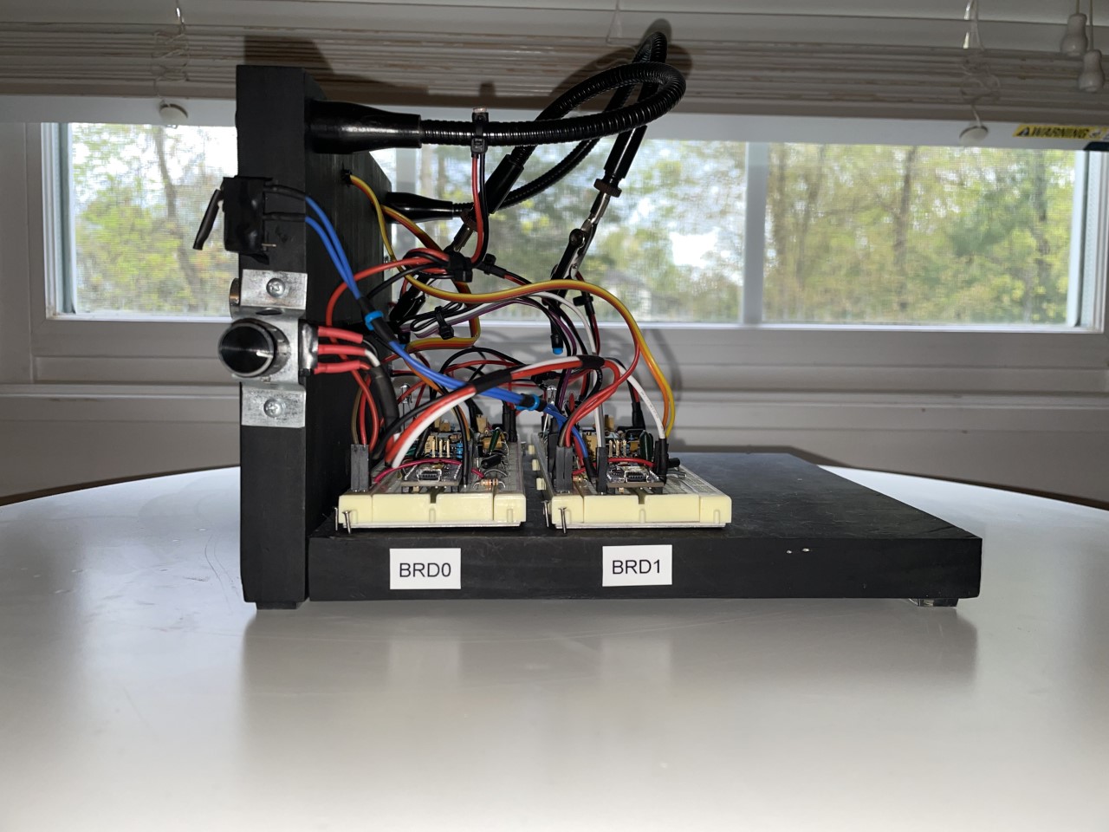
Photos and Captures/Test Fixture/right.jpg
