kharper55/LiFi-Serial/Photos and Captures/Test Fixture/top.jpg

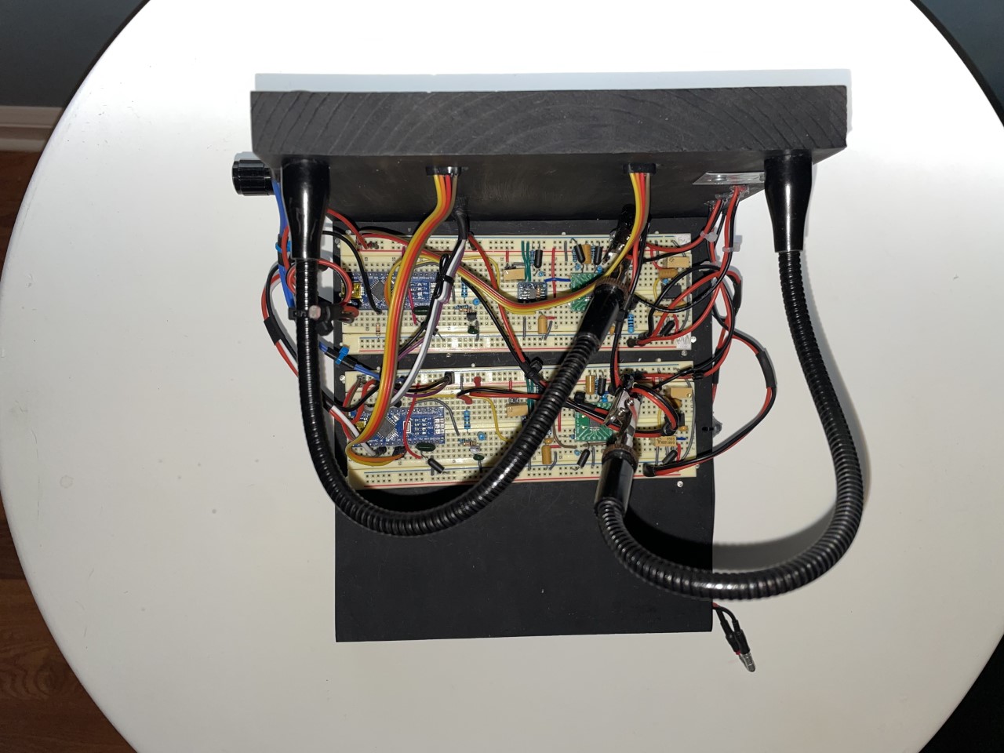
Photos and Captures/Test Fixture/top.jpg
