kharper55/LiFi-Serial/Schematics/LiFiREVB.pdf

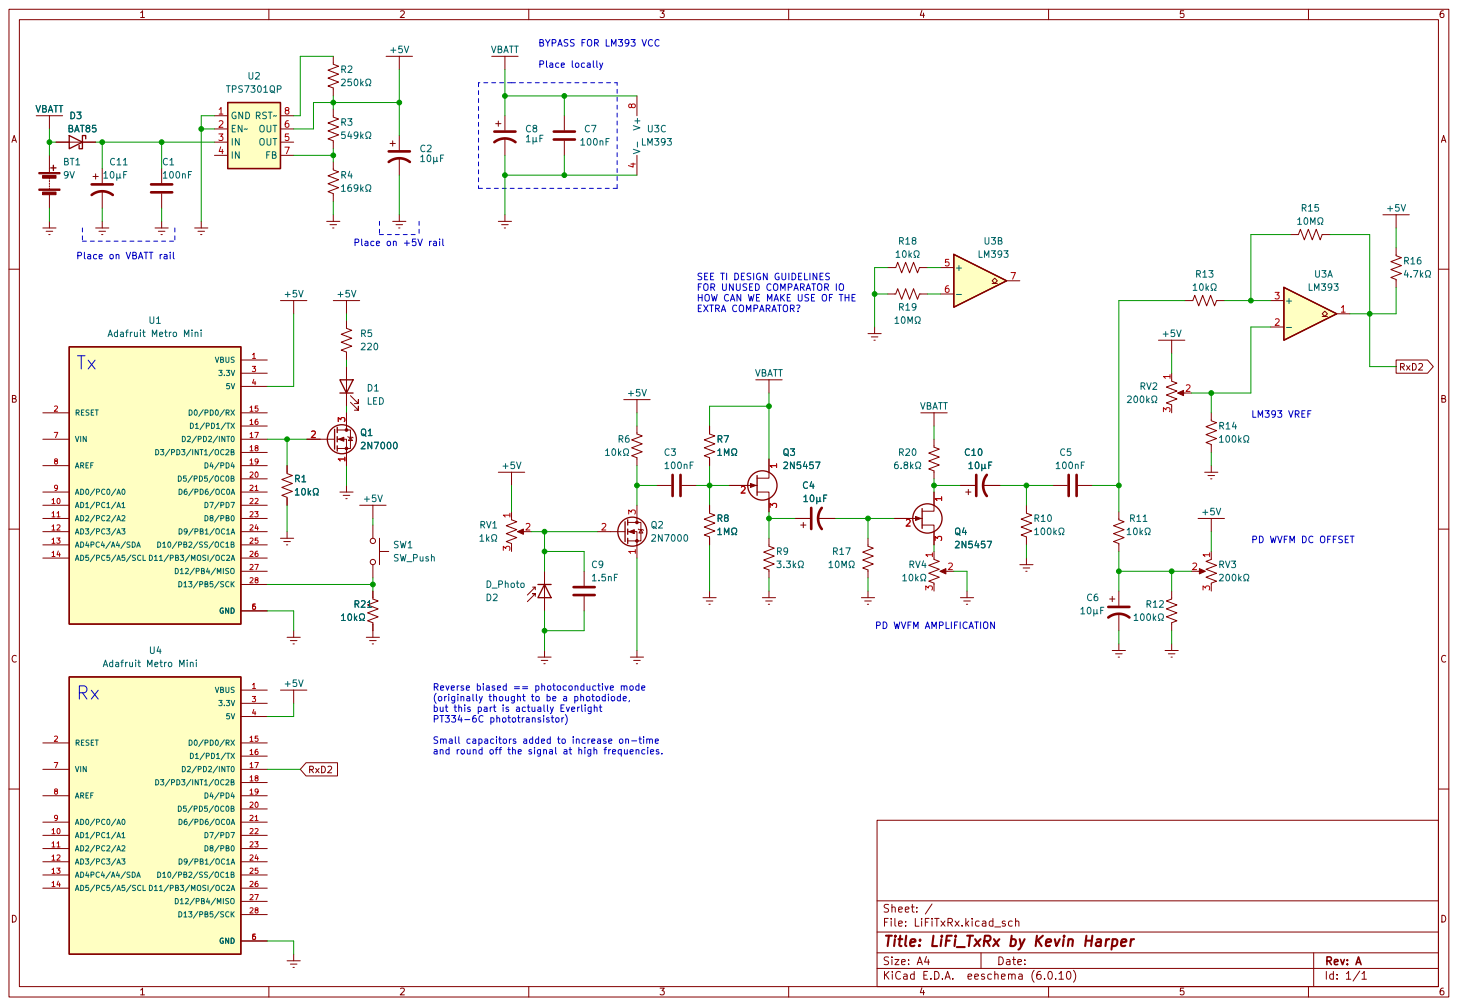
[picture p42: page 1]

FOR UNUSED COMPARATOR IO
HOW CAN WE MAKE USE OF THE

LM393 VREF PD WVFM AMPLIFICATION

(originally thought to be a photodiode,
but this part is actually Everlight
PT334-6C phototransistor)

Small capacitors added to increase on-time
and round off the signal at high frequencies.

File: LiFiTxRx.kicad_sch Sheet: /
Id: 1/1 Title: LiFi_TxRx by Kevin Harper
